CNCBASHER/SmoothieDriver/README.txt

SmoothieDriverDualDC is an open source two channel closed loop feedback dc motor controller using an arm cortex-m0 mcu (lpc1227) to drive two +-1.5A full h-bridge drivers (a4973).

The firmware is compiled using the LPCXpresso Studio for now.
