CNCBASHER/SmoothieDriver/board/DualDC/SmoothieDriverDualDC.png

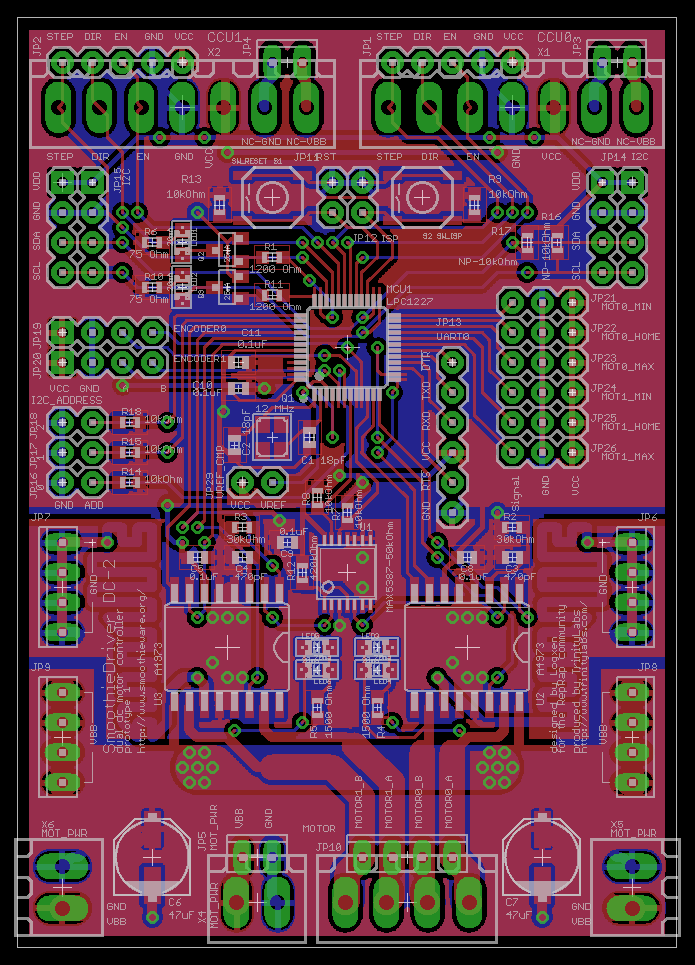
board/DualDC/SmoothieDriverDualDC.png
