CNCBASHER/SmoothieDriver/board/DualDC/SmoothieDriverDualDC BoM.xls

Digi-Key Part Number | Manufacturer | Manufacturer Part Number | Customer Reference | Quantity 1 | Quantity 2 | Quantity 3 | Description | Comments | RoHS Status | Lead Free Status | REACH Status
568-5163-ND | NXP SEMICONDUCTORS | LPC1227FBD48/301,1 |  | 1 | 0 | 0 | MCU 32BIT 128K FLASH 8K 48-LQFP |  | RoHS Compliant | Lead free | Unaffected Jul-2011
MAX5387MAUD+-ND | MAXIM INTEGRATED PRODUCTS | MAX5387MAUD+ |  | 1 | 0 | 0 | IC POT DGTL 256-TAP 14TSSOP | Alternate Packaging Exists | RoHS Compliant | Lead free | Unaffected Dec-2010
620-1438-1-ND | ALLEGRO MICROSYSTEMS INC (VA) | A4973SLBTR-T |  | 2 | 0 | 0 | IC PWM MOTOR DVR FULL 16SOIC | Alternate Packaging Exists | RoHS Compliant | Lead free | Unaffected Jun-2011
478-6620-1-ND | AVX CORPORATION (VA) | CX3225GB12000D0HEQZ1 |  | 1 | 0 | 0 | CRYSTAL 12.000MHZ 8PF SMD | Alternate Packaging Exists | RoHS compliant by exemption | Contains lead | Unaffected Jun-2012
568-1636-1-ND | NXP SEMICONDUCTORS (VA) | BC847C,215 |  | 2 | 0 | 0 | TRANS NPN GP 100MA 45V SOT23 | Alternate Packaging Exists | RoHS Compliant | Lead free | Unaffected Jul-2011
754-1128-1-ND | KINGBRIGHT CORP (VA) | APT2012EC |  | 6 | 0 | 0 | LED 2X1.2MM 625NM RD WTR CLR SMD | Alternate Packaging Exists | RoHS Compliant | Lead free | Unaffected Feb-2011
450-1759-1-ND | TE CONNECTIVITY ALCOSWITCH (VA) | FSM4JSMATR |  | 2 | 0 | 0 | SWITCH TACTILE SPST-NO 0.05A 12V | Alternate Packaging Exists | RoHS Compliant | Lead free | Unaffected Aug-2011
490-1524-1-ND | MURATA ELECTRONICS (VA) | GRM188R71E104KA01D |  | 5 | 0 | 0 | CAP CER 0.1UF 25V 10% X7R 0603 | Alternate Packaging Exists | RoHS Compliant | Lead free | Unaffected Jul-2011
PCE3951CT-ND | PANASONIC ELECTRONIC COMPONENTS (VA) | EEE-1VA101XP |  | 2 | 0 | 0 | CAP ALUM 100UF 35V 20% SMD | Alternate Packaging Exists | RoHS Compliant | Lead free | Not Available
490-1443-1-ND | MURATA ELECTRONICS (VA) | GRM1885C1H471JA01D |  | 2 | 0 | 0 | CAP CER 470PF 50V 5% NP0 0603 | Alternate Packaging Exists | RoHS Compliant | Lead free | Unaffected Jul-2011
490-1409-1-ND | MURATA ELECTRONICS (VA) | GRM1885C1H180JA01D |  | 2 | 0 | 0 | CAP CER 18PF 50V 5% NP0 0603 | Alternate Packaging Exists | RoHS Compliant | Lead free | Unaffected Jul-2011
P10KGCT-ND | PANASONIC ELECTRONIC COMPONENTS (VA) | ERJ-3GEYJ103V |  | 7 | 0 | 0 | RES 10K OHM 1/10W 5% 0603 SMD | Alternate Packaging Exists | RoHS Compliant | Lead free | Not Available
P412KHCT-ND | PANASONIC ELECTRONIC COMPONENTS (VA) | ERJ-3EKF4123V |  | 1 | 0 | 0 | RES 412K OHM 1/10W 1% 0603 SMD | Alternate Packaging Exists | RoHS Compliant | Lead free | Not Available
P75GCT-ND | PANASONIC ELECTRONIC COMPONENTS (VA) | ERJ-3GEYJ750V |  | 2 | 0 | 0 | RES 75 OHM 1/10W 5% 0603 SMD | Alternate Packaging Exists | RoHS Compliant | Lead free | Not Available
P1.5KGCT-ND | PANASONIC ELECTRONIC COMPONENTS (VA) | ERJ-3GEYJ152V |  | 2 | 0 | 0 | RES 1.5K OHM 1/10W 5% 0603 SMD | Alternate Packaging Exists | RoHS Compliant | Lead free | Not Available
P30KGCT-ND | PANASONIC ELECTRONIC COMPONENTS (VA) | ERJ-3GEYJ303V |  | 2 | 0 | 0 | RES 30K OHM 1/10W 5% 0603 SMD | Alternate Packaging Exists | RoHS Compliant | Lead free | Not Available
P1.2KGCT-ND | PANASONIC ELECTRONIC COMPONENTS (VA) | ERJ-3GEYJ122V |  | 2 | 0 | 0 | RES 1.2K OHM 1/10W 5% 0603 SMD | Alternate Packaging Exists | RoHS Compliant | Lead free | Not Available
