CNCBASHER/SmoothieDriver/board/DualDC/SmoothieDriverDualDC.brd

## EAGLE design board/DualDC/SmoothieDriverDualDC.brd (2012-08-14)

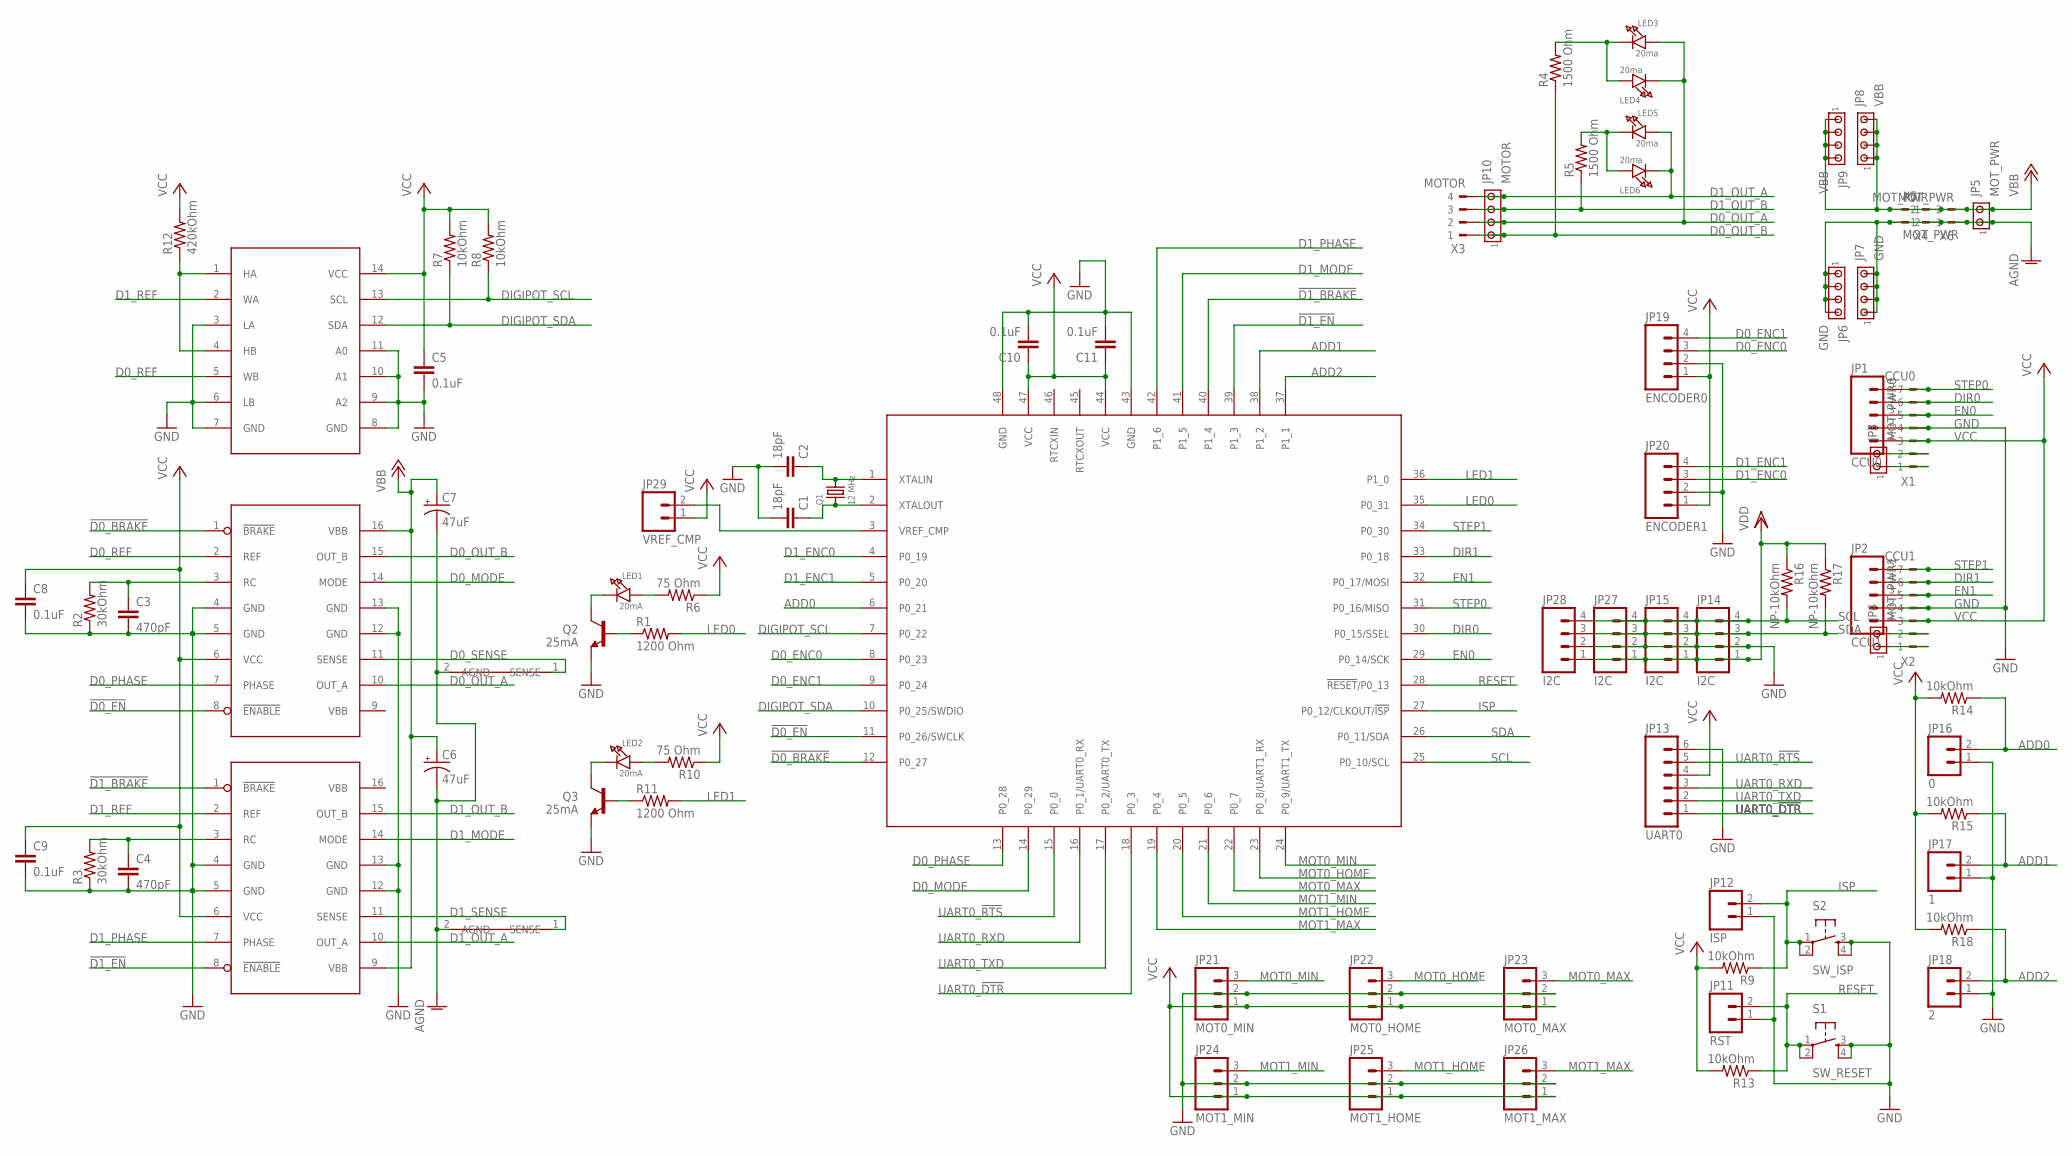
[picture p2: schematic SmoothieDriverDualDC.sch]

Parts:
C1, C2: 18pF; C0603
C3, C4: 470pF; C0603
C5, C8, C9, C10, C11: 0.1uF; C0603
C6, C7: 47uF; PANASONIC_D
JP1: CCU0; 1X05
JP2: CCU1; 1X05
JP3: MOT_PWR0; 10X02MTA
JP4: MOT_PWR1; 10X02MTA
JP5: MOT_PWR; 10X02MTA
JP6, JP7: GND; 10X04MTA
JP8, JP9: VBB; 10X04MTA
JP10: MOTOR; 10X04MTA
JP11: RST; 1X02
JP12: ISP; 1X02
JP13: UART0; 1X06
JP14, JP15, JP27, JP28: I2C; 1X04
JP16: 0; 1X02
JP17: 1; 1X02
JP18: 2; 1X02
JP19: ENCODER0; 1X04
JP20: ENCODER1; 1X04
JP21: MOT0_MIN; 1X03
JP22: MOT0_HOME; 1X03
JP23: MOT0_MAX; 1X03
JP24: MOT1_MIN; 1X03
JP25: MOT1_HOME; 1X03
JP26: MOT1_MAX; 1X03
JP29: VREF_CMP; 1X02
LED1, LED2: 20mA; CHIPLED_0805
LED3, LED4, LED5, LED6: 20ma; CHIPLED_0805
MCU1: LPC1227; LQFP48
Q1: 12 MHz; CRYSTAL_3.2X2.5
Q2, Q3: 25mA; SOT23
R1, R11: 1200 Ohm; R0603
R2, R3: 30kOhm; R0603
R4, R5: 1500 Ohm; R0603
R6, R10: 75 Ohm; R0603
R7, R8, R9, R13, R14, R15, R18: 10kOhm; R0603
R12: 420kOhm; R0603
R16, R17: NP-10kOhm; R0603
S1: SW_RESET; TACTILE_SWITCH_SMD
S2: SW_ISP; TACTILE_SWITCH_SMD
U1: MAX5387-50kOhm; TSSOP14
U2, U3: A4973; SO16L
U$1, U$2: CONNECTOR; CONNECT
X1: CCU0; 180G-7
X2: CCU1; 180G-7
X3: MOTOR; 180G-4
X4, X5, X6: MOT_PWR; 180G-2

Connections:
!D0_BRAKE: MCU1.12 (P0_27), U2.1 (!BRAKE)
!D0_EN: MCU1.11 (P0_26/SWCLK), U2.8 (!ENABLE)
!D1_BRAKE: MCU1.40 (P1_4), U3.1 (!BRAKE)
!D1_EN: MCU1.39 (P1_3), U3.8 (!ENABLE)
ADD0: JP16.2, MCU1.6 (P0_21), R14.1
ADD1: JP17.2, MCU1.38 (P1_2), R15.1
ADD2: JP18.2, MCU1.37 (P1_1), R18.1
AGND: C6.-, C7.-, JP5.1, JP6.1, JP6.2, JP6.3, JP6.4, JP7.1, JP7.2, JP7.3, JP7.4, U$1.2 (AGND), U$2.2 (AGND), X4.1, X5.2, X6.1
D0_ENC0: JP19.3, MCU1.8 (P0_23)
D0_ENC1: JP19.4, MCU1.9 (P0_24)
D0_MODE: MCU1.14 (P0_29), U2.14 (MODE)
D0_OUT_A: JP10.2, LED3.A, LED4.C, U2.10 (OUT_A), X3.2
D0_OUT_B: JP10.1, R4.1, U2.15 (OUT_B), X3.1
D0_PHASE: MCU1.13 (P0_28), U2.7 (PHASE)
D0_REF: U1.5 (WB), U2.2 (REF)
D0_SENSE: U2.11 (SENSE), U$2.1 (SENSE)
D1_ENC0: JP20.3, MCU1.4 (P0_19)
D1_ENC1: JP20.4, MCU1.5 (P0_20)
D1_MODE: MCU1.41 (P1_5), U3.14 (MODE)
D1_OUT_A: JP10.4, LED5.A, LED6.C, U3.10 (OUT_A), X3.4
D1_OUT_B: JP10.3, R5.1, U3.15 (OUT_B), X3.3
D1_PHASE: MCU1.42 (P1_6), U3.7 (PHASE)
D1_REF: U1.2 (WA), U3.2 (REF)
D1_SENSE: U3.11 (SENSE), U$1.1 (SENSE)
DIGIPOT_SCL: MCU1.7 (P0_22), R8.1, U1.13 (SCL)
DIGIPOT_SDA: MCU1.10 (P0_25/SWDIO), R7.1, U1.12 (SDA)
DIR0: JP1.4, MCU1.30 (P0_15/SSEL), X1.6
DIR1: JP2.4, MCU1.33 (P0_18), X2.6
EN0: JP1.3, MCU1.29 (P0_14/SCK), X1.5
EN1: JP2.3, MCU1.32 (P0_17/MOSI), X2.5
GND: C1.2, C2.2, C3.2, C4.2, C5.2, C8.2, C9.2, C10.2, C11.2, JP1.2, JP2.2, JP11.1, JP12.1, JP13.6, JP14.2, JP15.2, JP16.1, JP17.1, JP18.1, JP19.2, JP20.2, JP21.2, JP22.2, JP23.2, JP24.2, JP25.2, JP26.2, JP27.2, JP28.2, MCU1.43 (GND), MCU1.48 (GND), Q2.2 (E), Q3.2 (E), R2.1, R3.1, S1.3, S1.4, S2.3, S2.4, U1.3 (LA), U1.6 (LB), U1.7 (GND), U1.8 (GND), U1.9 (A2), U1.10 (A1), U1.11 (A0), U2.4 (GND), U2.5 (GND), U2.12 (GND), U2.13 (GND), U3.4 (GND), U3.5 (GND), U3.12 (GND), U3.13 (GND), X1.4, X2.4
ISP: JP12.2, MCU1.27 (P0_12/CLKOUT/!ISP), R9.1, S2.1, S2.2
LED0: MCU1.35 (P0_31), R1.2
LED1: MCU1.36 (P1_0), R11.2
MOT0_HOME: JP22.3, MCU1.23 (P0_8/UART1_RX)
MOT0_MAX: JP23.3, MCU1.22 (P0_7)
MOT0_MIN: JP21.3, MCU1.24 (P0_9/UART1_TX)
MOT1_HOME: JP25.3, MCU1.20 (P0_5)
MOT1_MAX: JP26.3, MCU1.19 (P0_4)
MOT1_MIN: JP24.3, MCU1.21 (P0_6)
unnamed: LED1.A, R6.2
unnamed: LED1.C, Q2.3 (C)
unnamed: C3.1, R2.2, U2.3 (RC)
unnamed: C2.1, MCU1.1 (XTALIN), Q1.2
unnamed: C1.1, MCU1.2 (XTALOUT), Q1.1
unnamed: Q2.1 (B), R1.1
unnamed: Q3.1 (B), R11.1
unnamed: C4.1, R3.2, U3.3 (RC)
unnamed: LED2.A, R10.2
unnamed: LED2.C, Q3.3 (C)
unnamed: R12.1, U1.1 (HA), U1.4 (HB)
unnamed: LED5.C, LED6.A, R5.2
unnamed: LED3.C, LED4.A, R4.2
unnamed: JP4.2, X2.2
unnamed: JP4.1, X2.1
unnamed: JP3.2, X1.2
unnamed: JP3.1, X1.1
unnamed: JP29.2, MCU1.3 (VREF_CMP)
RESET: JP11.2, MCU1.28 (!RESET!/P0_13), R13.1, S1.1, S1.2
SCL: JP14.4, JP15.4, JP27.4, JP28.4, MCU1.25 (P0_10/SCL), R16.2
SDA: JP14.3, JP15.3, JP27.3, JP28.3, MCU1.26 (P0_11/SDA), R17.2
STEP0: JP1.5, MCU1.31 (P0_16/MISO), X1.7
STEP1: JP2.5, MCU1.34 (P0_30), X2.7
UART0_!DTR!: JP13.1, MCU1.18 (P0_3)
UART0_!RTS!: JP13.5, MCU1.15 (P0_0)
UART0_RXD: JP13.3, MCU1.16 (P0_1/UART0_RX)
UART0_TXD: JP13.2, MCU1.17 (P0_2/UART0_TX)
VBB: C6.+, C7.+, JP5.2, JP8.1, JP8.2, JP8.3, JP8.4, JP9.1, JP9.2, JP9.3, JP9.4, U2.16 (VBB), U3.9 (VBB), X4.2, X5.1, X6.2
VCC: C5.1, C8.1, C9.1, C10.1, C11.1, JP1.1, JP2.1, JP13.4, JP19.1, JP20.1, JP21.1, JP22.1, JP23.1, JP24.1, JP25.1, JP26.1, JP29.1, MCU1.44 (VCC), MCU1.47 (VCC), R6.1, R7.2, R8.2, R9.2, R10.1, R12.2, R13.2, R14.2, R15.2, R18.2, U1.14 (VCC), U2.6 (VCC), U3.6 (VCC), X1.3, X2.3
VDD: JP14.1, JP15.1, JP27.1, JP28.1, R16.1, R17.1

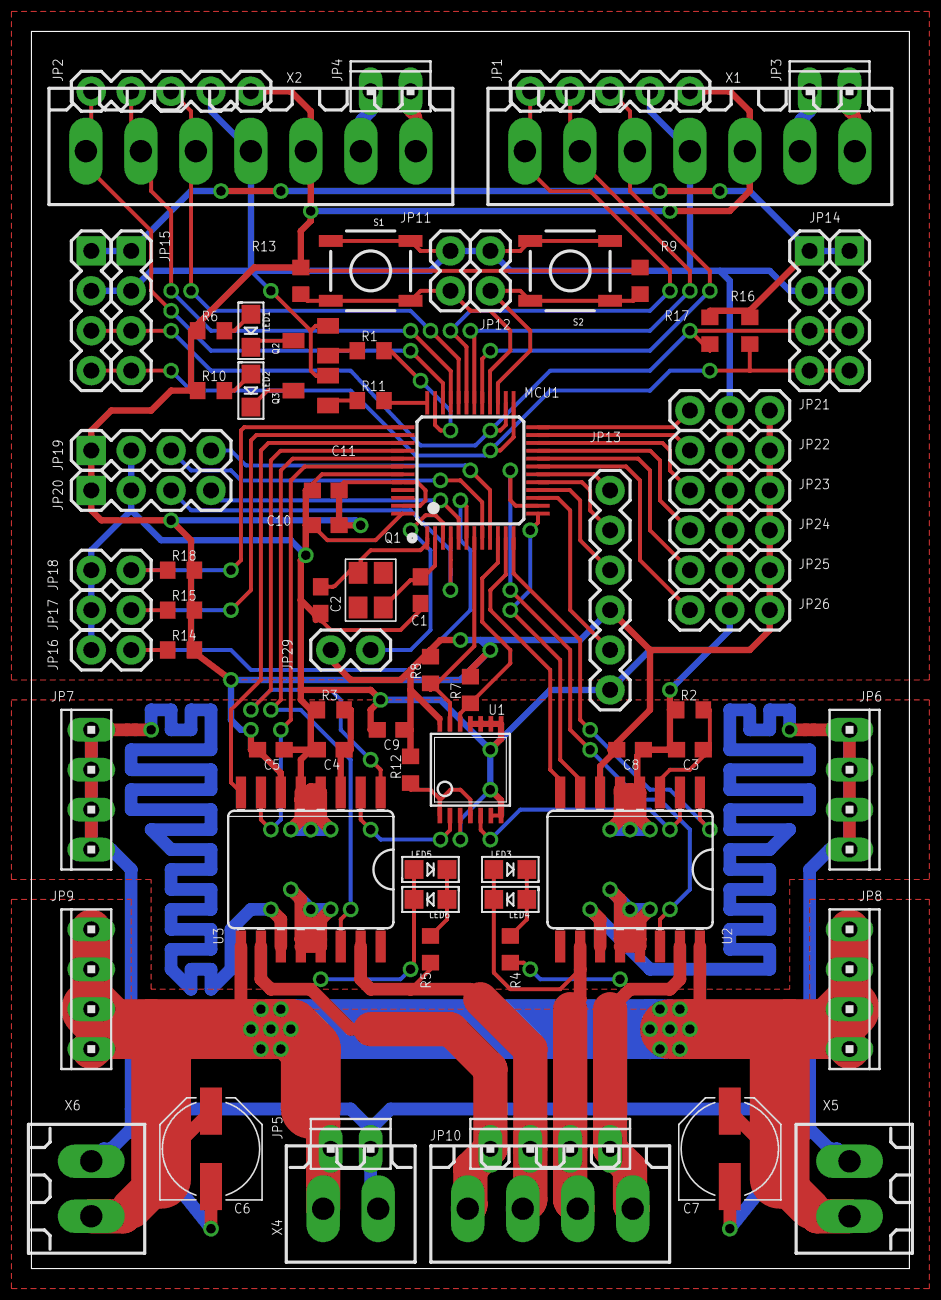
[picture p3: board SmoothieDriverDualDC.brd from above]

Board: 2 copper layers, 55.9 x 78.7 mm, 81 parts (0 on the bottom side), 70 nets.
